ostojaatanasijevic/boss_DS1/README.md

# TPI pedals - BSDS1

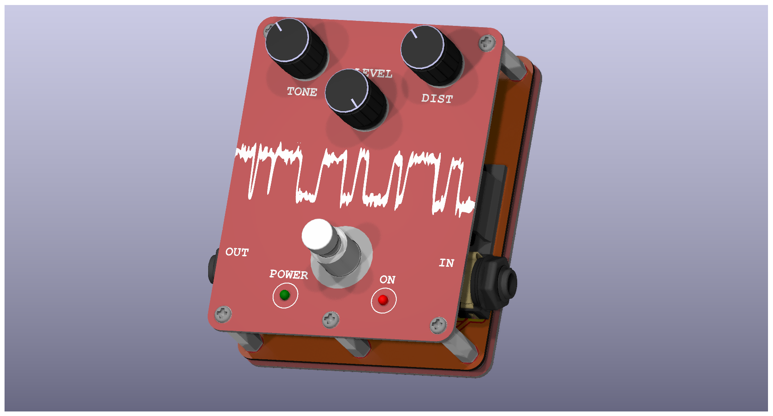
[picture p1: boss_DS1/boss_DS1_side.png]
side_view

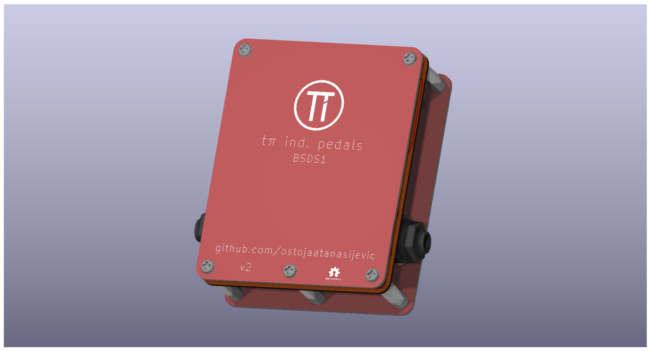
[picture p2: boss_DS1/boss_DS1_bottom.png]
top_view


## Schematic
schematic
