ostojaatanasijevic/boss_DS1/boss_DS1/boss_DS1_top.png

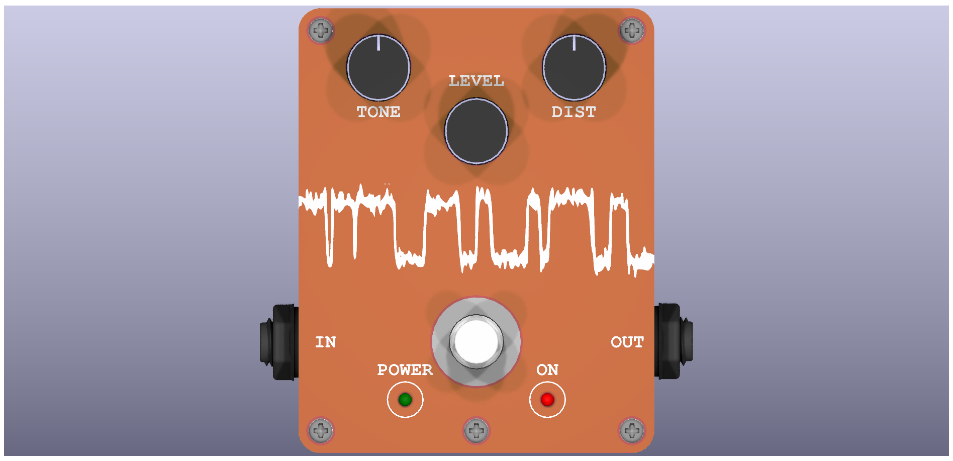
boss_DS1/boss_DS1_top.png
