ostojaatanasijevic/boss_DS1/boss_DS1_bottom_plate/boss_DS1_bottom_plate.step

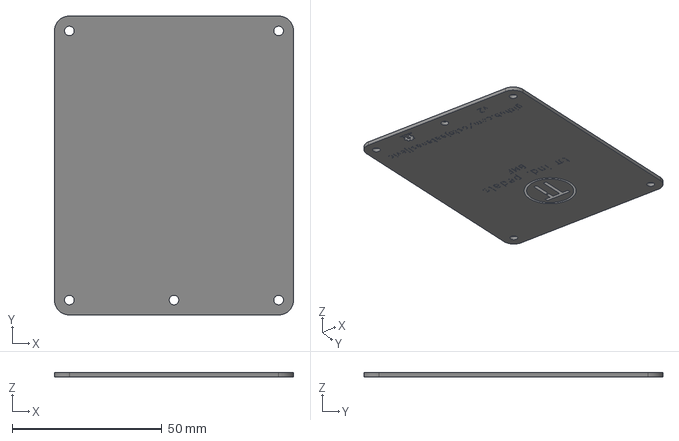
[picture p4: CAD file, 2025-05-13]
boss_DS1_bottom_plate/boss_DS1_bottom_plate.step
80.0 x 100.0 x 1.58 mm
big_muff_pi_bottom_plate_silkscreen
big_muff_pi_bottom_plate_PCB
