ostojaatanasijevic/boss_DS1/boss_DS1_front_plate/boss_DS1_front_plate.step

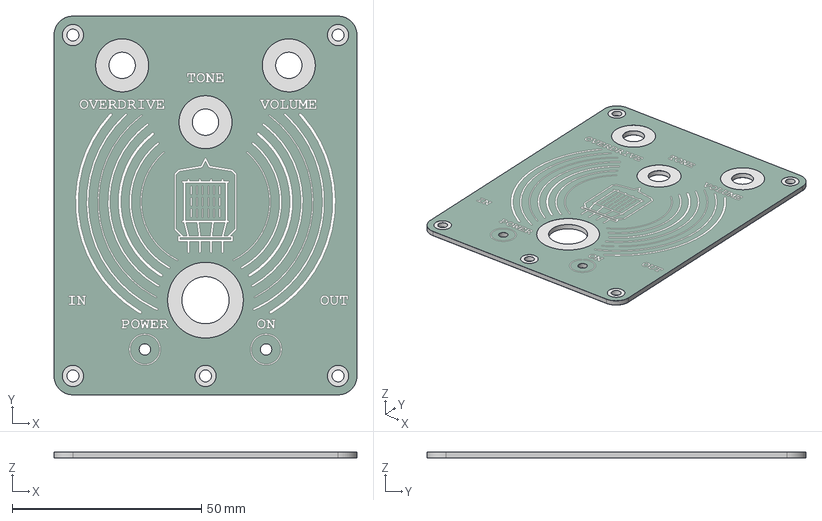
[picture p5: CAD file, 2025-05-09]
boss_DS1_front_plate/boss_DS1_front_plate.step
80.0 x 100.0 x 1.66 mm
tube_screamer_front_plate_copper
tube_screamer_front_plate_pad
tube_screamer_front_plate_silkscreen
tube_screamer_front_plate_soldermask
tube_screamer_front_plate_PCB
