ostojaatanasijevic/boss_DS1/bottom_plate.step

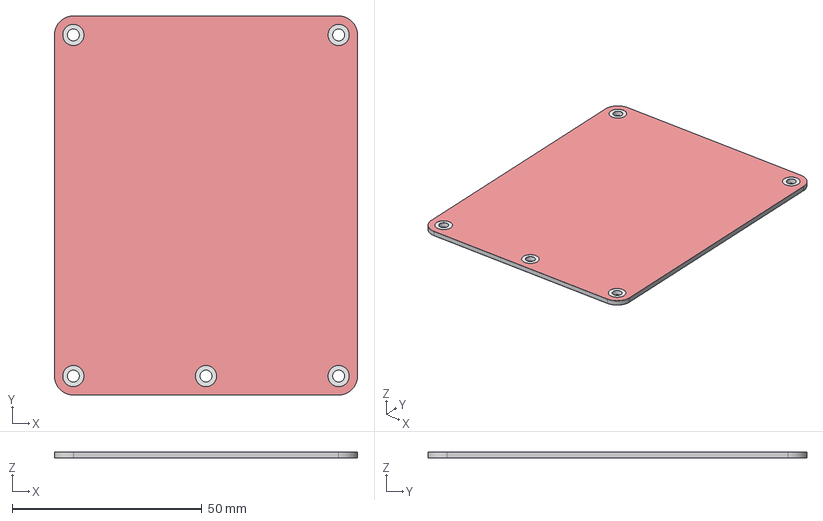
[picture p6: CAD file, 2025-05-22]
bottom_plate.step
80.0 x 100.0 x 1.64 mm
boss_DS1_bottom_plate_pad
boss_DS1_bottom_plate_silkscreen
boss_DS1_bottom_plate_soldermask
boss_DS1_bottom_plate_PCB
