ostojaatanasijevic/boss_DS1/boss_DS1_bottom_plate/9V-battery.stp

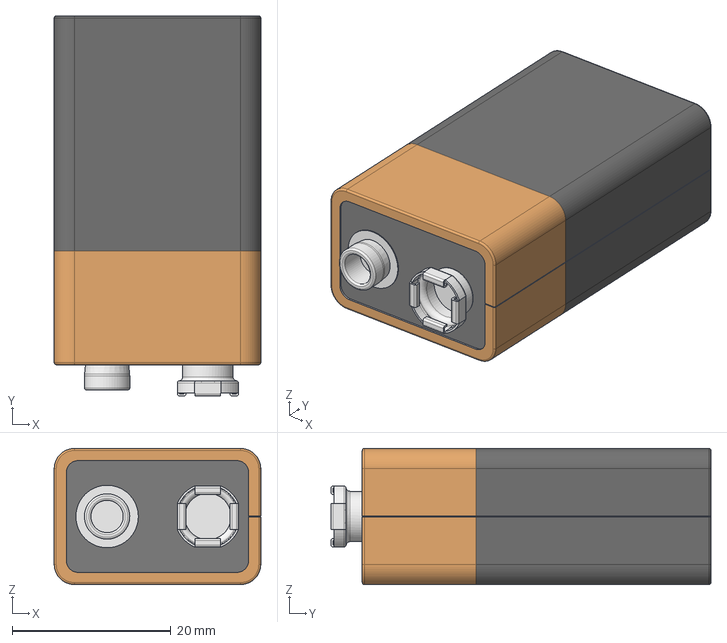
[picture p7: CAD file, 2025-05-09]
boss_DS1_bottom_plate/9V-battery.stp
26.0 x 47.9 x 17.1 mm
