ostojaatanasijevic/boss_DS1/boss_DS1_bottom_plate/switch.STEP

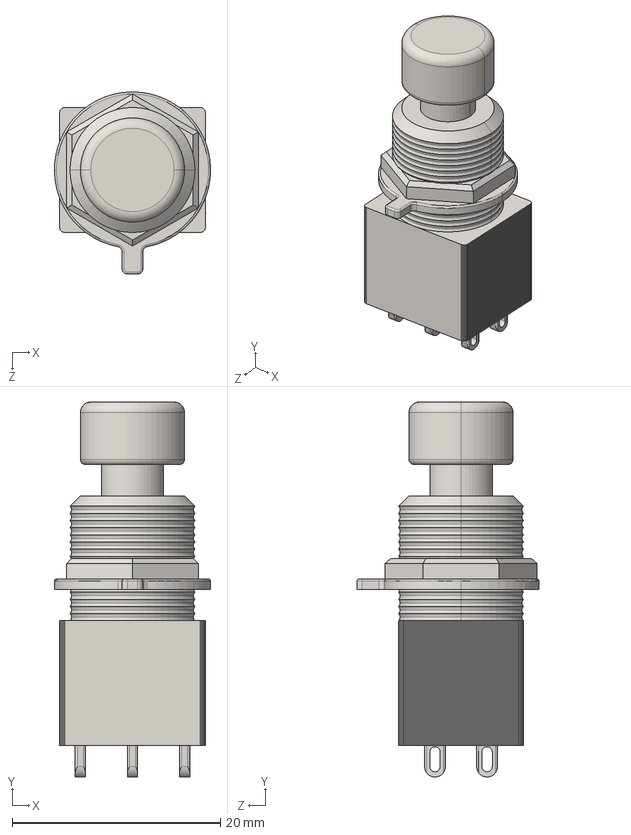
[picture p8: CAD file, 2025-05-09]
boss_DS1_bottom_plate/switch.STEP
15.0 x 36.0 x 17.5 mm
