ostojaatanasijevic/boss_DS1/boss_DS1_bottom_plate/NMJ6HFD2-AU--3DModel-STEP-418109.STEP

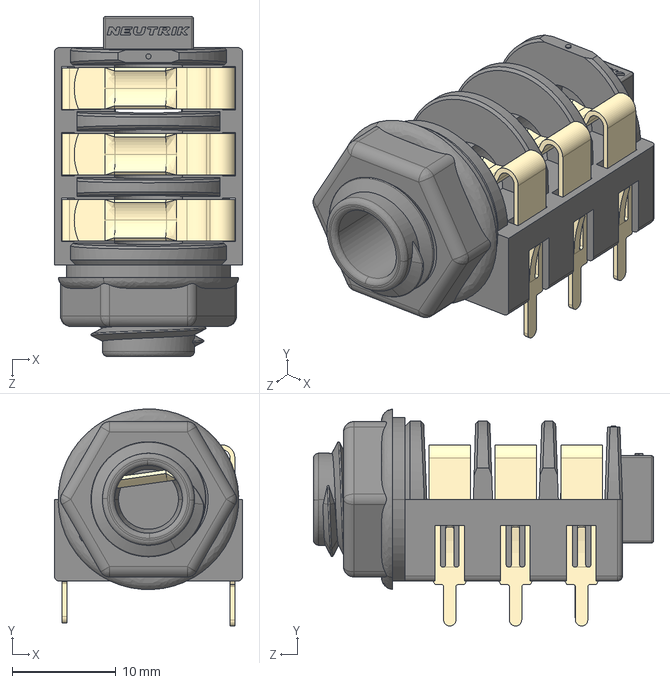
[picture p9: CAD file, 2025-04-05]
boss_DS1_bottom_plate/NMJ6HFD2-AU--3DModel-STEP-418109.STEP
18.2 x 21.0 x 32.9 mm
