ostojaatanasijevic/boss_DS1/boss_DS1/boss_DS1.kicad_pcb

## KiCad design boss_DS1/boss_DS1.kicad_pcb (2025-05-24)

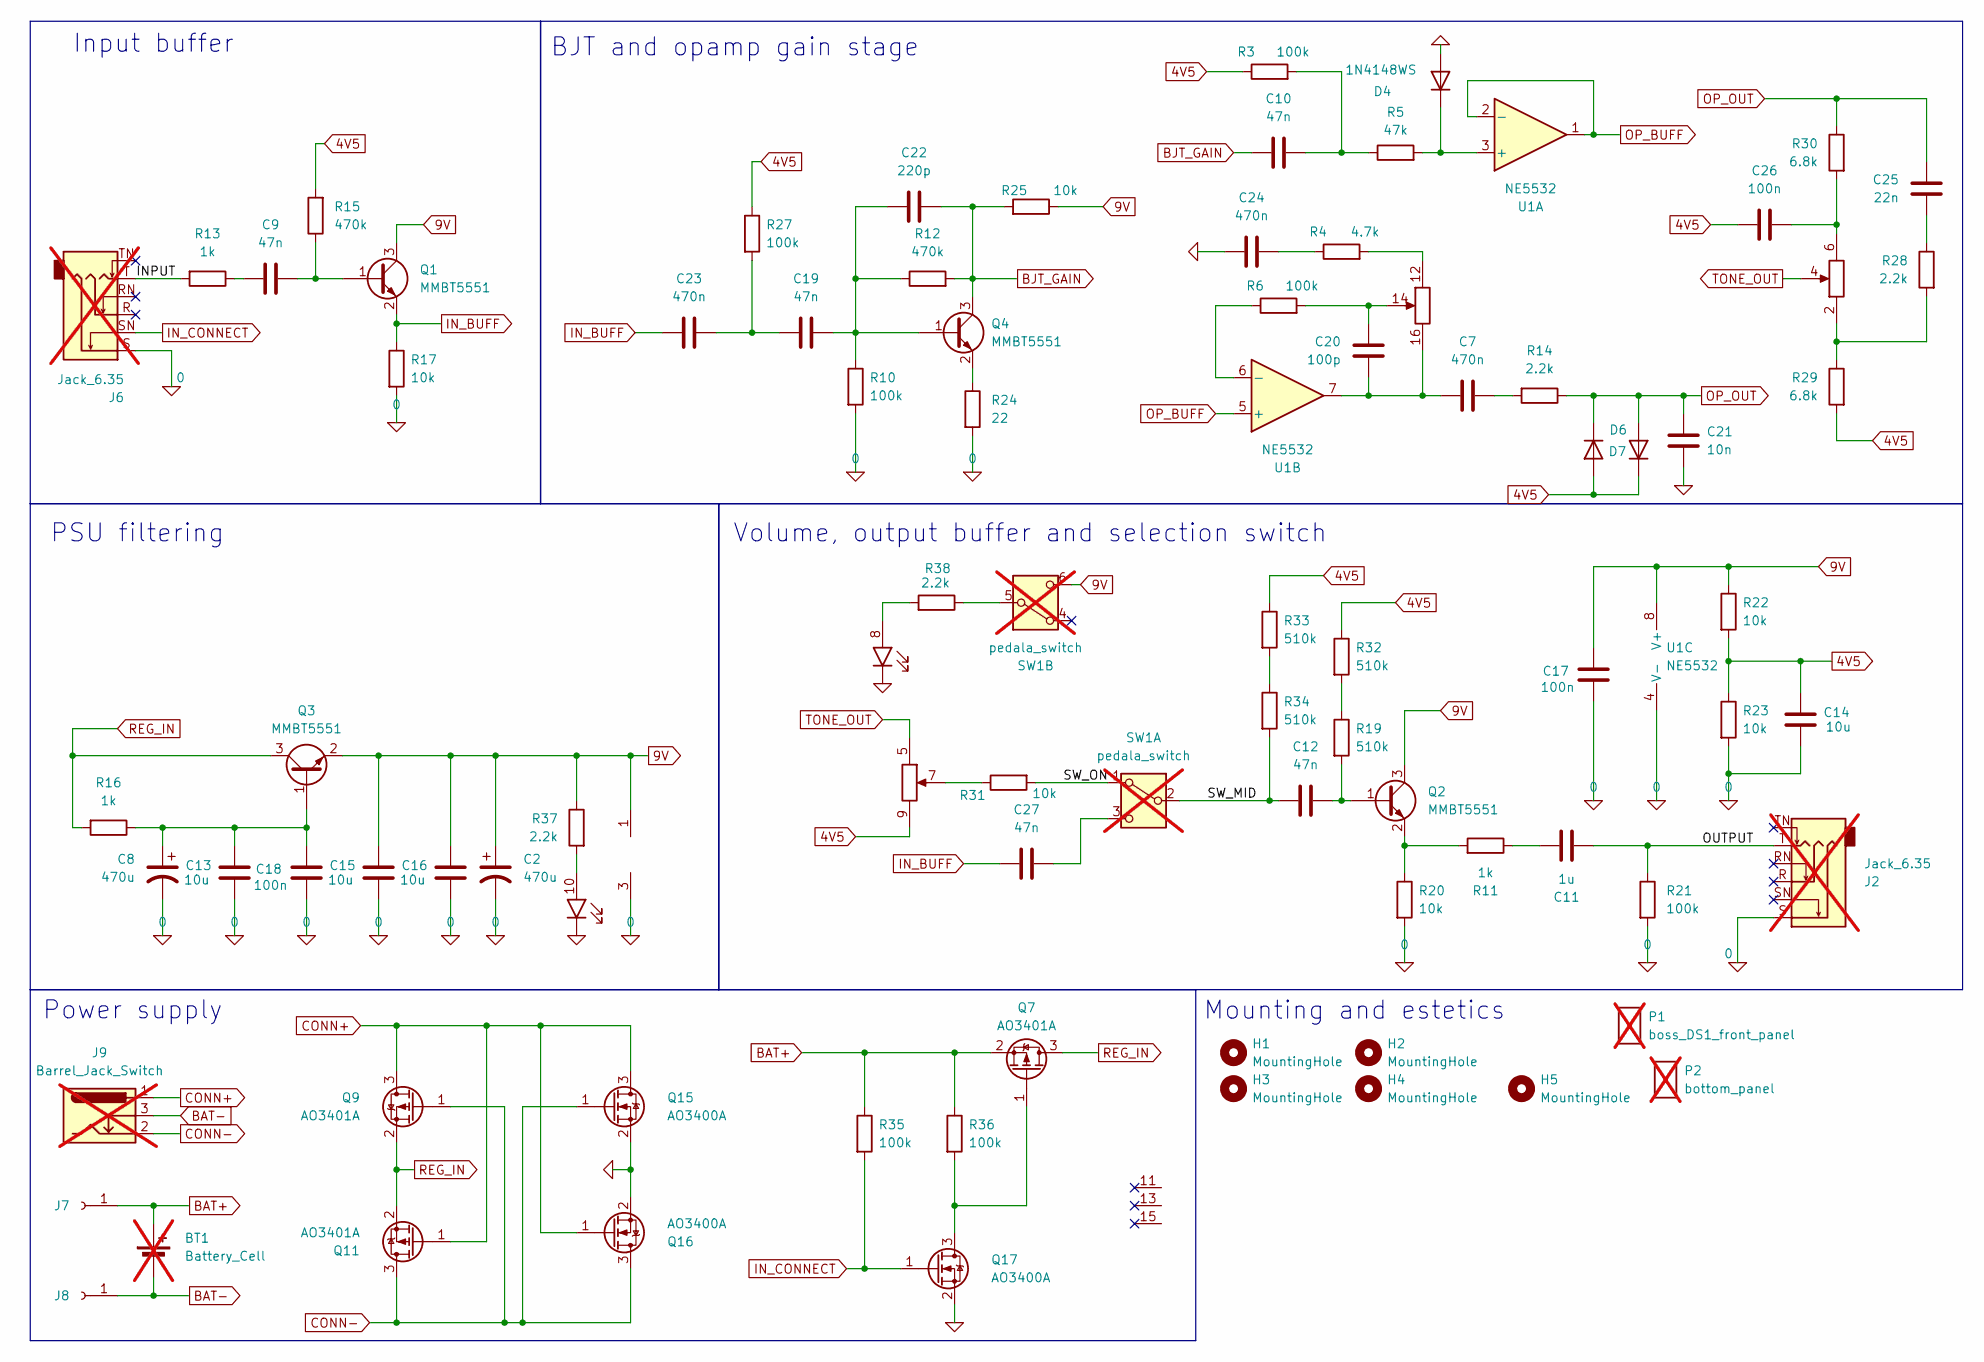
[picture p11: schematic boss_DS1.kicad_sch]

Parts:
BT1: Battery_Cell; BatteryHolder_Eagle_12BH611-GR; not fitted
C2, C8: 470u; CP_Radial_D8.0mm_P3.50mm
C7, C23, C24: 470n; C_0603_1608Metric_Pad1.08x0.95mm_HandSolder; LCSC C1623
C9, C10, C12, C19, C27: 47n; C_0603_1608Metric_Pad1.08x0.95mm_HandSolder; LCSC C1622
C11: 1u; C_0603_1608Metric_Pad1.08x0.95mm_HandSolder; LCSC C15849
C13, C14, C15, C16: 10u; C_0603_1608Metric_Pad1.08x0.95mm_HandSolder; LCSC C96446
C17, C18, C26: 100n; C_0603_1608Metric_Pad1.08x0.95mm_HandSolder; LCSC C14663
C20: 100p; C_0603_1608Metric_Pad1.08x0.95mm_HandSolder; LCSC C14858
C21: 10n; C_0603_1608Metric_Pad1.08x0.95mm_HandSolder; LCSC C57112
C22: 220p; C_0603_1608Metric_Pad1.08x0.95mm_HandSolder; LCSC C1603
C25: 22n; C_0603_1608Metric_Pad1.08x0.95mm_HandSolder; LCSC C21122
D4, D6, D7: 1N4148WS; D_SOD-323; LCSC C2128
H1, H2, H3, H4, H5: MountingHole; M3_hole_with_spacer
J1: top_panel_connector; IDC-Header_2x08_P2.54mm_Vertical
J2, J6: Jack_6.35; Jack_6.35mm; not fitted
J7, J8: Conn_01x01_Socket; TestPoint_THTPad_D2.5mm_Drill1.2mm
J9: Barrel_Jack_Switch; BarrelJack; not fitted
P1: boss_DS1_front_panel; boss_DS1_front_plate; not fitted
P2: bottom_panel; bottom_plate; not fitted
Q1, Q2, Q3, Q4: MMBT5551; SOT-23; LCSC C2145
Q7, Q9, Q11: AO3401A; SOT-23; LCSC C15127
Q15, Q16, Q17: AO3400A; SOT-23; LCSC C20917
R3, R6, R10, R21, R27, R35, R36: 100k; R_0603_1608Metric_Pad0.98x0.95mm_HandSolder; LCSC C25803
R4: 4.7k; R_0603_1608Metric_Pad0.98x0.95mm_HandSolder; LCSC C23162
R5: 47k; R_0603_1608Metric_Pad0.98x0.95mm_HandSolder; LCSC C25819
R11, R13, R16: 1k; R_0603_1608Metric_Pad0.98x0.95mm_HandSolder; LCSC C21190
R12, R15: 470k; R_0603_1608Metric_Pad0.98x0.95mm_HandSolder; LCSC C23178
R14, R28, R37, R38: 2.2k; R_0603_1608Metric_Pad0.98x0.95mm_HandSolder; LCSC C4190
R17, R20, R22, R23, R25, R31: 10k; R_0603_1608Metric_Pad0.98x0.95mm_HandSolder; LCSC C25804
R19, R32, R33, R34: 510k; R_0603_1608Metric_Pad0.98x0.95mm_HandSolder; LCSC C23192
R24: 22; R_0603_1608Metric_Pad0.98x0.95mm_HandSolder; LCSC C23345
R29, R30: 6.8k; R_0603_1608Metric_Pad0.98x0.95mm_HandSolder; LCSC C23212
SW1: pedala_switch; foot_switch_tht_no_pad; not fitted
U1: NE5532; SOIC-8_3.9x4.9mm_P1.27mm; LCSC C7426

Connections:
0: C2.2, C8.2, C13.2, C14.2, C15.2, C16.2, C17.1, C18.1, C21.1, C24.1, D4.2 (A), J1.3 (GND), J2.S, J6.S, Q15.2 (S), Q16.2 (S), Q17.2 (S), R10.2, R17.2, R20.2, R21.2, R23.2, R24.2, U1.4 (V-)
4V5: C14.1, C26.2, D6.2 (A), D7.1 (K), J1.9, R3.1, R15.2, R22.2, R23.1, R27.1, R29.2, R32.1, R33.1
9V: C2.1, C15.1, C16.1, C17.2, J1.1 (VCC), Q1.3 (C), Q2.3 (C), Q3.2 (E), R22.1, R25.1, R37.1, SW1.6 (C), U1.8 (V+)
/INPUT: J6.T, R13.2
/OUTPUT: C11.2, J2.T, R21.1
/SW_MID: C12.1, R34.2, SW1.2 (B)
/SW_ON: R31.2, SW1.1 (A)
BAT+: BT1.1 (+), J7.1, Q7.2 (S), R35.1, R36.1
BAT-: BT1.2 (-), J8.1, J9.3
BJT_GAIN: C10.1, C22.2, Q4.3 (C), R12.2, R25.2
CONN+: J9.1, Q9.3 (D), Q11.1 (G), Q15.3 (D), Q16.1 (G)
CONN-: J9.2, Q9.1 (G), Q11.3 (D), Q15.1 (G), Q16.3 (D)
IN_BUFF: C23.1, C27.1, Q1.2 (E), R17.1
IN_CONNECT: J6.SN, Q17.1 (G), R35.2
unnamed: C7.2, R14.2
unnamed: C9.1, R13.1
unnamed: C10.2, R3.2, R5.1
unnamed: C11.1, R11.1
unnamed: C19.1, C23.2, R27.2
unnamed: C24.2, R4.1
unnamed: C25.1, R28.1
unnamed: D4.1 (K), R5.2, U1.3 (+)
unnamed: J1.2, R28.2, R29.1
unnamed: C26.1, J1.6, R30.2
unnamed: J1.7, R31.1
unnamed: J1.12, R4.2
unnamed: C20.2, J1.14, R6.2
unnamed: C7.1, C20.1, J1.16, U1.7
unnamed: J1.8, R38.2
unnamed: J1.10, R37.2
unnamed: C9.2, Q1.1 (B), R15.1
unnamed: C12.2, Q2.1 (B), R19.2
unnamed: Q2.2 (E), R11.2, R20.1
unnamed: C8.1, C13.1, C18.2, Q3.1 (B), R16.1
unnamed: C19.2, C22.1, Q4.1 (B), R10.1, R12.1
unnamed: Q4.2 (E), R24.1
unnamed: Q7.1 (G), Q17.3 (D), R36.2
unnamed: R19.1, R32.2
unnamed: R33.2, R34.1
unnamed: C27.2, SW1.3 (C)
unnamed: R38.1, SW1.5 (B)
unnamed: R6.1, U1.6 (-)
OP_BUFF: U1.1, U1.2 (-), U1.5 (+)
OP_OUT: C21.2, C25.2, D6.1 (K), D7.2 (A), R14.1, R30.1
REG_IN: Q3.3 (C), Q7.3 (D), Q9.2 (S), Q11.2 (S), R16.2
TONE_OUT: J1.4, J1.5

Notes on the sheet:
Input buffer
Mounting and estetics
PSU filtering
BJT and opamp gain stage
Volume, output buffer and selection switch
Power supply

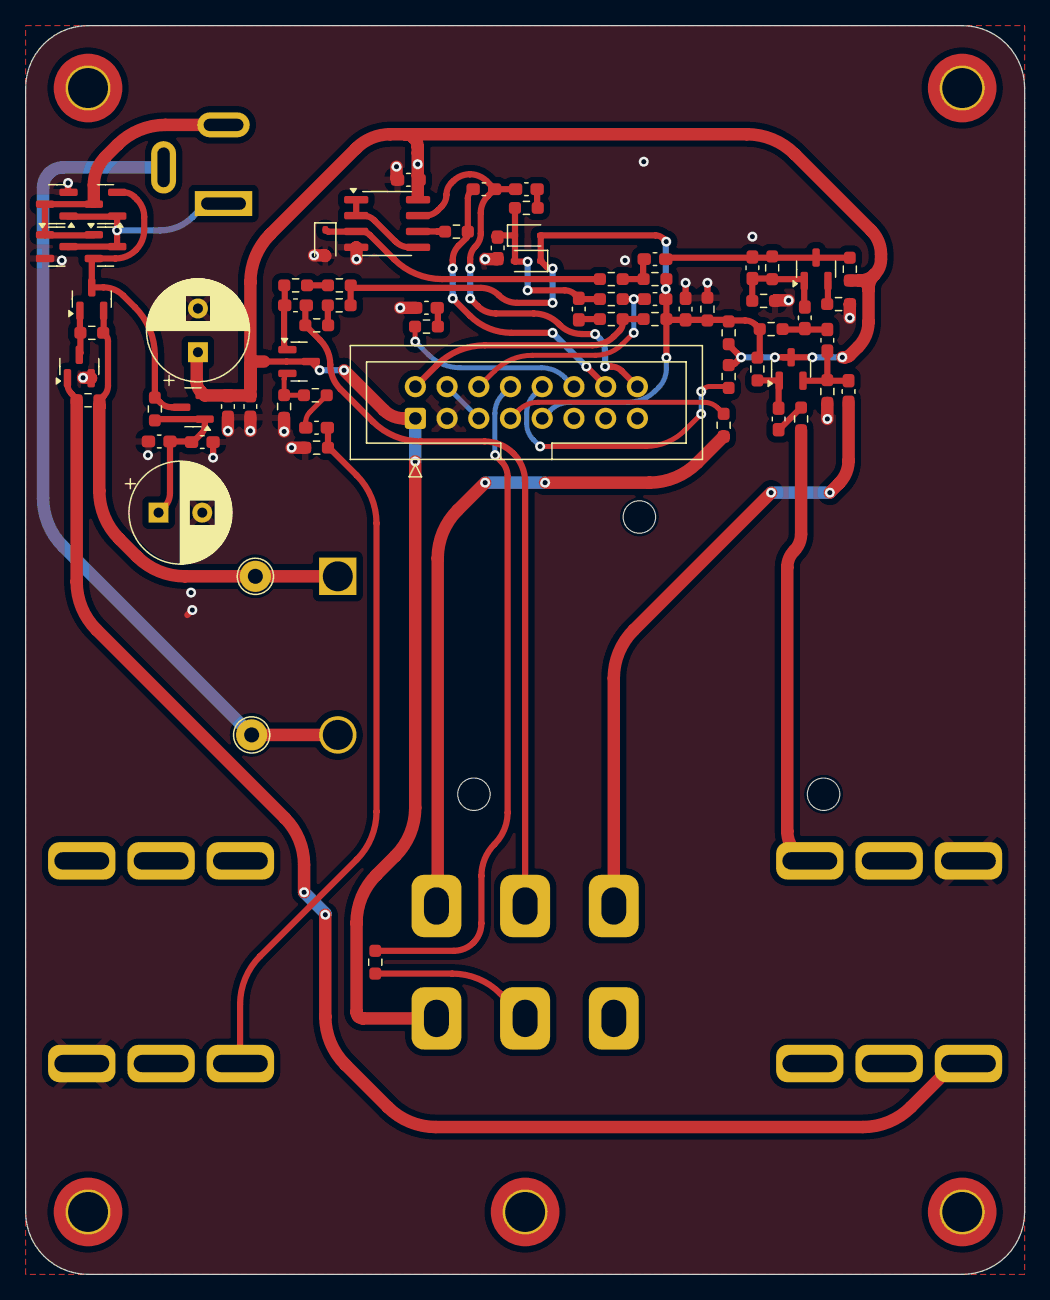
[picture p12: board boss_DS1.kicad_pcb from above]

Board: 2 copper layers, 80.0 x 100.0 mm, 84 parts (0 on the bottom side), 46 nets.

Other parts of the board:
D8: floating_green_led
D9: floating_red_led
