ostojaatanasijevic/boss_DS1/(commit log)

2025-04-04 rutiranje v1.
    [boss_DS1.kicad_pcb]
2025-04-04 rutiranje v2.
    [boss_DS1.kicad_pcb]
2025-04-04 Rutiranje v3
    [boss_DS1.kicad_pcb]
2025-04-04 verzija v4
    [boss_DS1.kicad_pcb]
2025-04-05 All errors fixed
    [boss_DS1.kicad_pcb, boss_DS1.kicad_sch]
2025-04-06 Updated front plate
2025-05-09 New phone who dis.
    [3-d-nmj6hhd2.stp, 9V-battery.stp, NMJ6HFD2-AU--3DModel-STEP-418109.STEP, boss_DS1_front_plate.kicad_pcb, boss_DS1_front_plate.kicad_sch, boss_DS1_front_plate.step, switch.STEP]
2025-05-13 Added plate proj.
    [3-d-nmj6hhd2.stp, 9V-battery.stp, NMJ6HFD2-AU--3DModel-STEP-418109.STEP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]
2025-05-13 Updated front.
    [boss_DS1.kicad_pcb, boss_DS1.kicad_sch, boss_DS1_front_plate.kicad_pcb, boss_DS1_front_plate.kicad_sch, boss_DS1_front_plate.step]
2025-05-21 Updated libs.
    [boss_DS1.kicad_pcb, boss_DS1.kicad_sch]
2025-05-22 Potentiometers checked.
    [boss_DS1.kicad_pcb, boss_DS1.kicad_sch, boss_DS1_front_plate.kicad_pcb, boss_DS1_front_plate.kicad_sch]
2025-05-22 Pots again, done.
    [boss_DS1.kicad_sch, boss_DS1_front_plate.kicad_pcb, boss_DS1_front_plate.kicad_sch]
2025-05-22 Top plate routiran, valja proveriti pot-ove opet.
    [boss_DS1.kicad_sch, boss_DS1_front_plate.kicad_pcb, boss_DS1_front_plate.kicad_sch]
2025-05-22 Front plate update, diodes rotated.
    [boss_DS1.kicad_sch, boss_DS1_front_plate.kicad_pcb, boss_DS1_front_plate.kicad_sch]
2025-05-22 Added pot value label.
    [boss_DS1_front_plate.kicad_pcb]
2025-05-22 Top plate rounded.
    [boss_DS1_front_plate.kicad_pcb]
2025-05-22 Rutiranje gotovo
    [boss_DS1.kicad_pcb]
2025-05-22 updated conn
    [boss_DS1_front_plate.kicad_pcb]
2025-05-22 3d models update.
    [boss_DS1_front_plate.kicad_pcb]
2025-05-22 Updated all.
    [boss_DS1.kicad_pcb, boss_DS1.kicad_sch, boss_DS1_front_plate.kicad_pcb]
2025-05-22 Rounded traces.
    [boss_DS1.kicad_pcb]
2025-05-24 Ready for production.
    [bom.csv, boss_DS1.kicad_pcb, boss_DS1_bottom_plate.kicad_pcb, boss_DS1_front_plate.kicad_pcb, designators.csv, positions.csv]
